RoboticsBrno/ArduinoLearningKitStarter/docs/ArduinoIDE_LibraryManager_ALKS.png

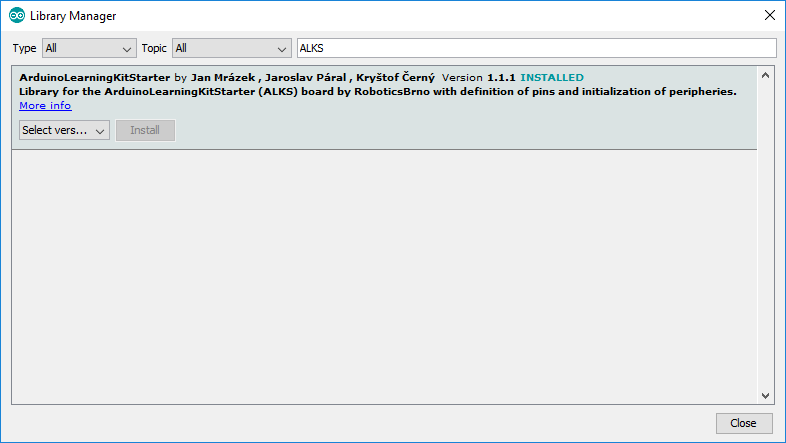
docs/ArduinoIDE_LibraryManager_ALKS.png
