RoboticsBrno/ArduinoLearningKitStarter/media/ALKS_v2.1_1.01_top.JPG

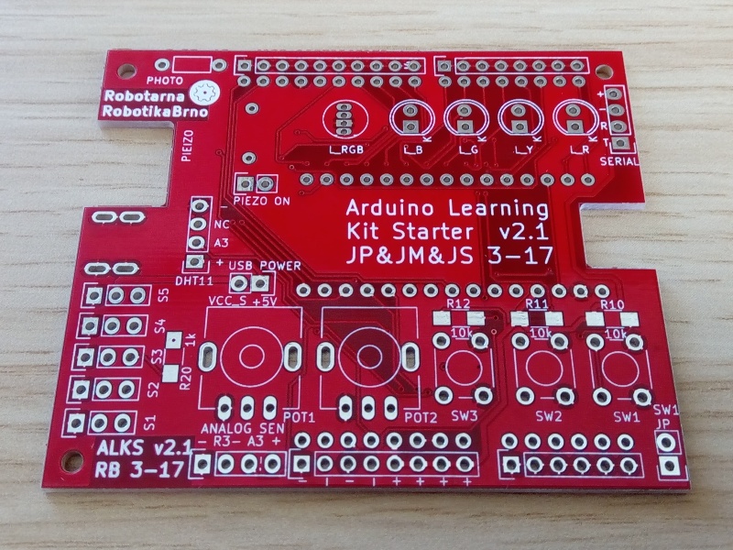
media/ALKS_v2.1_1.01_top.JPG
