RoboticsBrno/ArduinoLearningKitStarter/media/ALKS_v2.1_1.02_bot.JPG

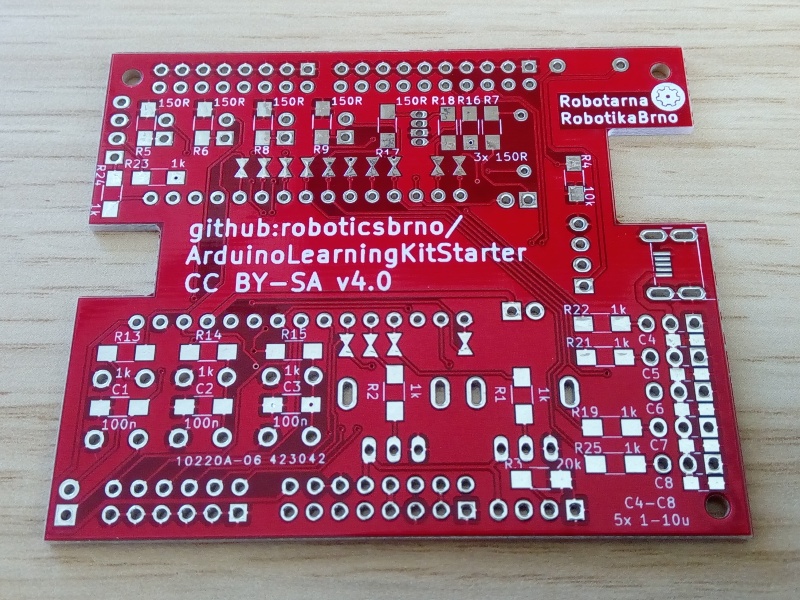
media/ALKS_v2.1_1.02_bot.JPG
