RoboticsBrno/ArduinoLearningKitStarter/(threads)

Thread 4 (2016-10-21):

Opravit pouzdro u potenciometrů + dokreslit obrys součástky do F.SilkS

JarekParal, 2016-10-21:
Nesedí velikost otvorů pro boční upevňovací nožičky (jsou moc úzké, je potřeba alespoň 2 mm).
Obrys součástky je jen v F.Fab -> potřeba přidat do F.SilkS.

JarekParal, 2017-03-31:
Rozteč mezi montážními otvory je příliš velká (potenciometry jdou špatně dát do DPS). Aktuálně je rozteč 10,8 mm a je potřeba ji zmenšit na cca. 9,8 mm (viz. http://www.taiwanalpha.com.tw/english2014/p_e_022.htm).

Closed 2017-03-31.

Thread 11 (2017-04-25):

Opravit IOREF u tlačítek, potenciometrů, světelného senzoru, DHT11, ...

JarekParal, 2017-04-25:
Je potřeba nahradit dráhy +5V za IOREF u pull-upů na tlačítka, u potenciometrů, světelného senzoru, na napájení DHT11 a je otázka co s pinheady J6 (UART/SERIAL) a J7 (analogové senzory). @cednik @yaqwsx

DHT11: [Spotřeba (str. 3)](https://www.gme.cz/data/attachments/dsh.772-137.2.pdf) čipu by měla být v desítkách miliampér a [napájecí napětí](https://www.gme.cz/data/attachments/dsh.772-137.1.pdf) od 3,3 (délka kabelu do 20 cm) do 5,5 V.

Aktuálně jsou totiž kity nekompatibilní s 3,3V procesory (ESP, ARM) a hrozí i jejich zničení.

yaqwsx, 2017-04-28:
#12 řeší.

Closed 2017-04-28.

Thread 13 (2017-05-31):

Opravit polohu a počet montážních otvorů

yaqwsx, 2017-05-31:

CornyjK, 2018-06-18:
Jak by se to mělo provést?

JarekParal, 2018-10-20:
@yaqwsx Nepamatuješ si, co přesně jsme chtěli upravit?

Přidat další díry v centimetrovém rastru?

yaqwsx, 2018-10-20:
Chceme 4 díry ve všech rozích. Chceme kulaté rohy.

Dne 20.10.2018 v 17:28 Jaroslav Páral napsal(a):
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

JarekParal, 2018-10-20:
Já myslel, že ty aktuální tři montážní otvory jsou právě Uno kompatibilní.

yaqwsx, 2018-10-20:
Vůbec, jsou na prasáka tam, kde bylo místo.

Honza

Dne 20.10.2018 v 20:38 Jaroslav Páral napsal(a):
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

JarekParal, 2018-12-20:
Finální řešení:
Součásné otvory odstranit a přidat 4 otvory, které budou odpovídat Arduino otvorům.
Přidat další 4 otvory do rohů DPS v milimetrovém/centimetrovém rastru.

Thread 16 (2017-07-09):

Chybějící popisky pinů pro ESP32

yaqwsx, 2017-07-09:
Používat pinheady s ESP32 je nepohodlné - je třeba dělat dle schématu dojí mapování

yaqwsx, 2018-01-23:
Vyřeší nová verze knihovny.

JarekParal, 2018-01-23:
A issue #20

Closed 2018-01-23.

Thread 19 (2018-01-23):

Doladit kompatibilitu Arduino - ESP32

yaqwsx, 2018-01-23:
Problémové je zejména I2C a SPI. Preferuji řešit na úrovni HW (ať je to blbuvzdornější) - tzn. defaultní piny na ESP32 (specifikované Arduino frameworkem) mapují na odpovídající piny na Arudinu.

Deska musí být použitelná jako redukce ESP32 < = > Arduino Nano < = > Arduino Uno

CornyjK, 2018-06-17:
Navrhuji uzavřít, protože je to záležitost knihovny a tam tato issue je.

JarekParal, 2018-06-18:
Řeší se v rámci issue v ALKS knihovně: https://github.com/RoboticsBrno/ArduinoLearningKitStarter-library/issues/5

Closed 2018-06-18.

Thread 20 (2018-01-23):

Přidat popisky pinů

yaqwsx, 2018-01-23:
Nejnutnější popisky přímo na desce, ostatní popisky bych přidal na vylupovací rámeček okolo celé desky (pokud budou popisky skutečně tak velké).

Nápad - v knihovně vytvořit kvůli kompatibilitě s ESP32 konstanty IO1, IO2, atd, které u Arduina budou definovány jako IO1 = 1, IO2 = 2; a u ESP32 např. IO1 = 12, IO2 = 14.

JarekParal, 2018-01-23:
Nápad (knihovna): navrhoval bych spíše přidat konstanty D1, D2, ..., A1, A2. A na DPS pak přidat klasické Arduino Uno popisky.

yaqwsx, 2018-01-23:
Souhlas

Thread 21 (2018-01-23):

Přidat konektory pro I2C a SPI

yaqwsx, 2018-01-23:
Nikdo si na Arduinu nepamatuje, kde je připojené I2C a kde je SPI. Je to třeba dohledávat a tohle je opruz. Buď chci mít popisky na desce anebo ještě extra pin heady, kde je přímo vyvedené I2C a SPI.

JarekParal, 2018-01-23:
Navrhuji nadefinovat I2C a SPI pro ESP32, tak jak je na klasickém Arduino Uno a přidat popisky na DPS pro Uno pinout.

yaqwsx, 2019-01-02:
Motivací pro mezeru byla snaha o vizuální oddělení. Můžu jí udělat větší.

Pořadí - máme nějaké zažité? Datové piny jsem dal sestupně dle čísel na
Arduinu.

st 2. 1. 2019 16:25 odesílatel Jaroslav Páral <notifications@github.com>
napsal:

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

JarekParal, 2019-01-16:
Po rychlém průzkumu konektorů na LCD displejů (většina je má tak jak jsou aktuálně na DPS) a Gyroskopů (praktický všechny to mají trochu jinak) bych konektory ponechal tak jsou a jen bych mezi nimi udělal mezeru o velikosti jednoho pindeadu (lepší pájení a jednotnost).

Thread 25 (2018-01-23):

Změna názvu knihovny pro ALKS

JarekParal, 2018-01-23:
Přejmenovat knihovnu LearningKit.h na ALKS.h (případně udělat ALKS.h jen jako include Learning.h). Děti mi v tom názvu dělají dost často chybu a nesedí to s názvem DPS.

Možná spíš issue do: https://github.com/RoboticsBrno/ArduinoLearningKitStarter-library

CornyjK, 2018-04-16:
Hotovo.

Closed 2018-04-16.

Thread 27 (2018-01-23):

Vyřešit připojení pieza na ESP32

yaqwsx, 2018-01-23:
Na ESP32 jsme v aktuální konfiguraci stále uspokojivě nerozpištěli piezo.

CornyjK, 2018-06-18:
Není to dobré řešení, ale fungovalo mi jen s jedním pinem na low a použít funkci ledc (není na AVR). Chtělo by to port knihovny ToneAC.

CornyjK, 2018-06-18:
Navrhuji zavřít, issue přesunut do RoboticsBrno/ArduinoLearningKitStarter-library#11

yaqwsx, 2018-06-18:
ToneAC dělá to, že na půl periody nastaví jednu nožičku na low a druhou na high a pak je prohodí. Díky tomu má piezo dvakrát tak velký rozkmit a je hlasitější.

To samé by mělo být možné udělat na ESPčku - nevím, jestli ledc umí invertovat pin nebo ne. Pokud ano, tak stačí nastavit oběma nožičkám PWM na 50 % a jeden pin invertovat. Pokud ne, tak by to mohly umět timery pro řízení motorů.

Thread 29 (2018-04-29):

Nefunguje SW1

CornyjK, 2018-04-29:
Alespoň na ESP32 ne, ostatní bez problémů, zkoušeni na více deskách s různými ESP32.

CornyjK, 2018-05-04:
Když mám zapojené ESP32 v ALKS a rovnou zkratuju IO15 s GND, tak to funguje,

CornyjK, 2018-05-05:
Dle mých aktuálních zjištění při zkratu R15 (rezistor sériově k tlačítku) tlačítko funguje. Možné řešení: zmenšení odporu?

Thread 30 (2018-06-11):

Opravit dokument s označením pinů

JarekParal, 2018-06-11:
Opravit dokument/tabulku s označením pinů ([XLS](https://github.com/RoboticsBrno/ArduinoLearningKitStarter/blob/master/docs/pinout.xlsx) i [PDF](https://github.com/RoboticsBrno/ArduinoLearningKitStarter/blob/master/docs/pinout.pdf)), tak aby odpovídala definici pinů v [ArduinoLearningKitStarter-library](https://github.com/RoboticsBrno/ArduinoLearningKitStarter-library) + přidat info, které označení platí pro Arduino Uno/Nano a které pro ESP32.

V budoucnu by mělo do ArduinoLearningKitStarter-library přibýt i ekvivalentní definice pinů pro ESP32 kompatibilní s Arduino Uno pinoutem ([issue 5](https://github.com/RoboticsBrno/ArduinoLearningKitStarter-library/issues/5)).

Thread 31 (2018-06-15):

Aktualizovat obrázky v readme.md

CornyjK, 2018-06-15:
Současné obrázky nejdou s dobou...

CornyjK, 2018-06-15:
Zároveň vytvořit obrázky i pro [wiki](https://github.com/RoboticsBrno/ArduinoLearningKitStarter/wiki/Nastavení-desky-ALKS).

JarekParal, 2018-06-18:
Na wiki můžeš použít tyhle obrázky/fotky: http://robotikabrno.cz/robotika-brno/navody/arduino/alks-tutorial-osazovani

Částečně by šli použít asi i na README.md.

Nové fotky nafotíme snad během tábora.

CornyjK, 2018-06-18:
Asi do wiki hodím i návod osazování.

JarekParal, 2018-06-18:
Souhlas. Přemýšlel jsem ještě, jestli celý návod nepřesunout na GitHub? @CornyjK

CornyjK, 2018-06-18:
Návod osazování?

CornyjK, 2018-06-18:
@JarekParal
Je osazovací návod ve správném znění (nejsou v něm chyby nebo změny)?

yaqwsx, 2018-06-18:
Nechceš vyrobit i obrázek s popisky pomocí https://github.com/yaqwsx/PcbDraw ?

JarekParal, 2019-06-03:
> Nechceš vyrobit i obrázek s popisky pomocí https://github.com/yaqwsx/PcbDraw ?

Ping @CornyjK ?

CornyjK, 2019-06-03:
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

Teď na to zrovna nemám čas.

Thread 32 (2018-06-18):

Vyřešit otevírání

CornyjK, 2018-06-18:
Při otevření ukáže:

```
The following libraries were not found:

robotarna_arduino-rescue

\home\xmrazek7\kicad\lib\kicad-library\library\Zilog

\home\xmrazek7\kicad\lib\kicad-library\library\xilinx

\home\xmrazek7\kicad\lib\kicad-library\library\Xicor

\home\xmrazek7\kicad\lib\kicad-library\library\Worldsemi

\home\xmrazek7\kicad\lib\kicad-library\library\video

\home\xmrazek7\kicad\lib\kicad-library\library\valves

\home\xmrazek7\kicad\lib\kicad-library\library\ttl_ieee

\home\xmrazek7\kicad\lib\kicad-library\library\transistors

\home\xmrazek7\kicad\lib\kicad-library\library\transf

\home\xmrazek7\kicad\lib\kicad-library\library\texas

\home\xmrazek7\kicad\lib\kicad-library\library\switches

\home\xmrazek7\kicad\lib\kicad-library\library\supertex

\home\xmrazek7\kicad\lib\kicad-library\library\stm32

\home\xmrazek7\kicad\lib\kicad-library\library\stm8

\home\xmrazek7\kicad\lib\kicad-library\library\siliconi

\home\xmrazek7\kicad\lib\kicad-library\library\silabs

\home\xmrazek7\kicad\lib\kicad-library\library\sensors

\home\xmrazek7\kicad\lib\kicad-library\library\rfcom

\home\xmrazek7\kicad\lib\kicad-library\library\relays

\home\xmrazek7\kicad\lib\kicad-library\library\regul

\home\xmrazek7\kicad\lib\kicad-library\library\references

\home\xmrazek7\kicad\lib\kicad-library\library\pspice

\home\xmrazek7\kicad\lib\kicad-library\library\Power_Management

\home\xmrazek7\kicad\lib\kicad-library\library\powerint

\home\xmrazek7\kicad\lib\kicad-library\library\power

\home\xmrazek7\kicad\lib\kicad-library\library\philips

\home\xmrazek7\kicad\lib\kicad-library\library\Oscillators

\home\xmrazek7\kicad\lib\kicad-library\library\opto

\home\xmrazek7\kicad\lib\kicad-library\library\onsemi

\home\xmrazek7\kicad\lib\kicad-library\library\nxp_armmcu

\home\xmrazek7\kicad\lib\kicad-library\library\nordicsemi

\home\xmrazek7\kicad\lib\kicad-library\library\msp430

\home\xmrazek7\kicad\lib\kicad-library\library\motorola

\home\xmrazek7\kicad\lib\kicad-library\library\motor_drivers

\home\xmrazek7\kicad\lib\kicad-library\library\microchip_pic32mcu

\home\xmrazek7\kicad\lib\kicad-library\library\microchip_pic18mcu

\home\xmrazek7\kicad\lib\kicad-library\library\microchip_pic16mcu

\home\xmrazek7\kicad\lib\kicad-library\library\microchip_pic12mcu

\home\xmrazek7\kicad\lib\kicad-library\library\microchip_pic10mcu

\home\xmrazek7\kicad\lib\kicad-library\library\microchip_dspic33dsc

\home\xmrazek7\kicad\lib\kicad-library\library\microchip

\home\xmrazek7\kicad\lib\kicad-library\library\microcontrollers

\home\xmrazek7\kicad\lib\kicad-library\library\memory

\home\xmrazek7\kicad\lib\kicad-library\library\maxim

\home\xmrazek7\kicad\lib\kicad-library\library\logo

\home\xmrazek7\kicad\lib\kicad-library\library\linear

\home\xmrazek7\kicad\lib\kicad-library\library\Lattice

\home\xmrazek7\kicad\lib\kicad-library\library\ir

\home\xmrazek7\kicad\lib\kicad-library\library\interface

\home\xmrazek7\kicad\lib\kicad-library\library\intel

\home\xmrazek7\kicad\lib\kicad-library\library\hc11

\home\xmrazek7\kicad\lib\kicad-library\library\graphic

\home\xmrazek7\kicad\lib\kicad-library\library\gennum

\home\xmrazek7\kicad\lib\kicad-library\library\ftdi

\home\xmrazek7\kicad\lib\kicad-library\library\ESD_Protection

\home\xmrazek7\kicad\lib\kicad-library\library\elec-unifil

\home\xmrazek7\kicad\lib\kicad-library\library\dsp

\home\xmrazek7\kicad\lib\kicad-library\library\display

\home\xmrazek7\kicad\lib\kicad-library\library\diode

\home\xmrazek7\kicad\lib\kicad-library\library\digital-audio

\home\xmrazek7\kicad\lib\kicad-library\library\device

\home\xmrazek7\kicad\lib\kicad-library\library\dc-dc

\home\xmrazek7\kicad\lib\kicad-library\library\cypress

\home\xmrazek7\kicad\lib\kicad-library\library\contrib

\home\xmrazek7\kicad\lib\kicad-library\library\conn

\home\xmrazek7\kicad\lib\kicad-library\library\cmos_ieee

\home\xmrazek7\kicad\lib\kicad-library\library\cmos4000

\home\xmrazek7\kicad\lib\kicad-library\library\brooktre

\home\xmrazek7\kicad\lib\kicad-library\library\bbd

\home\xmrazek7\kicad\lib\kicad-library\library\battery_management

\home\xmrazek7\kicad\lib\kicad-library\library\audio

\home\xmrazek7\kicad\lib\kicad-library\library\atmel

\home\xmrazek7\kicad\lib\kicad-library\library\analog_switches

\home\xmrazek7\kicad\lib\kicad-library\library\analog_devices

\home\xmrazek7\kicad\lib\kicad-library\library\Altera

\home\xmrazek7\kicad\lib\kicad-library\library\adc-dac

\home\xmrazek7\kicad\lib\kicad-library\library\actel

\home\xmrazek7\kicad\lib\kicad-library\library\ac-dc

\home\xmrazek7\kicad\lib\kicad-library\library\74xx

\home\xmrazek7\kicad\lib\kicad-library\library\74xgxx

\home\xmrazek7\kicad\lib\downloaded\shield_arduino

C:\Program Files\KiCad\share\kicad\library\graphic

C:\Program Files\KiCad\share\kicad\library\logo

\home\xmrazek7\kicad\yaqwsx_KiCAD_lib\symbols\yaqwsx
```
@yaqwsx ?

JarekParal, 2018-10-20:
@yaqwsx Lze v Kicad dělat nějak jinak reference na knihovny než do nějakých uživatelských složek? Jde přikládat knihovny přímo k projektu a referencovat je relativně vůči projektu?

JarekParal, 2018-10-30:
Jak jsi to vyřešil @CornyjK?

CornyjK, 2018-10-30:
@JarekParal v `CornyjK-WIP`.

Closed 2018-10-30.

Thread 33 (2018-10-16):

Aktualizovat seznam součástek

haberturdeur, 2018-10-16:

JarekParal, 2018-10-16:
Co přesně je za problém se seznamem součástek? Můžeš @haberturdeur dospecifikovat issue?

JarekParal, 2018-10-17:
Tady jsou seznamy všech používaných součástek na ALKS:
https://github.com/RoboticsBrno/ArduinoLearningKitStarter/wiki/Postup-osazov%C3%A1n%C3%AD
nebo
https://robotikabrno.cz/robotika-brno/navody/arduino/alks-tutorial-osazovani

Prosím případně o doplnění do [úvodní stránky](https://github.com/RoboticsBrno/ArduinoLearningKitStarter/blob/master/README.md),
