RoboticsBrno/ArduinoLearningKitStarter/docs/ArduinoLearningKitStarter.pdf

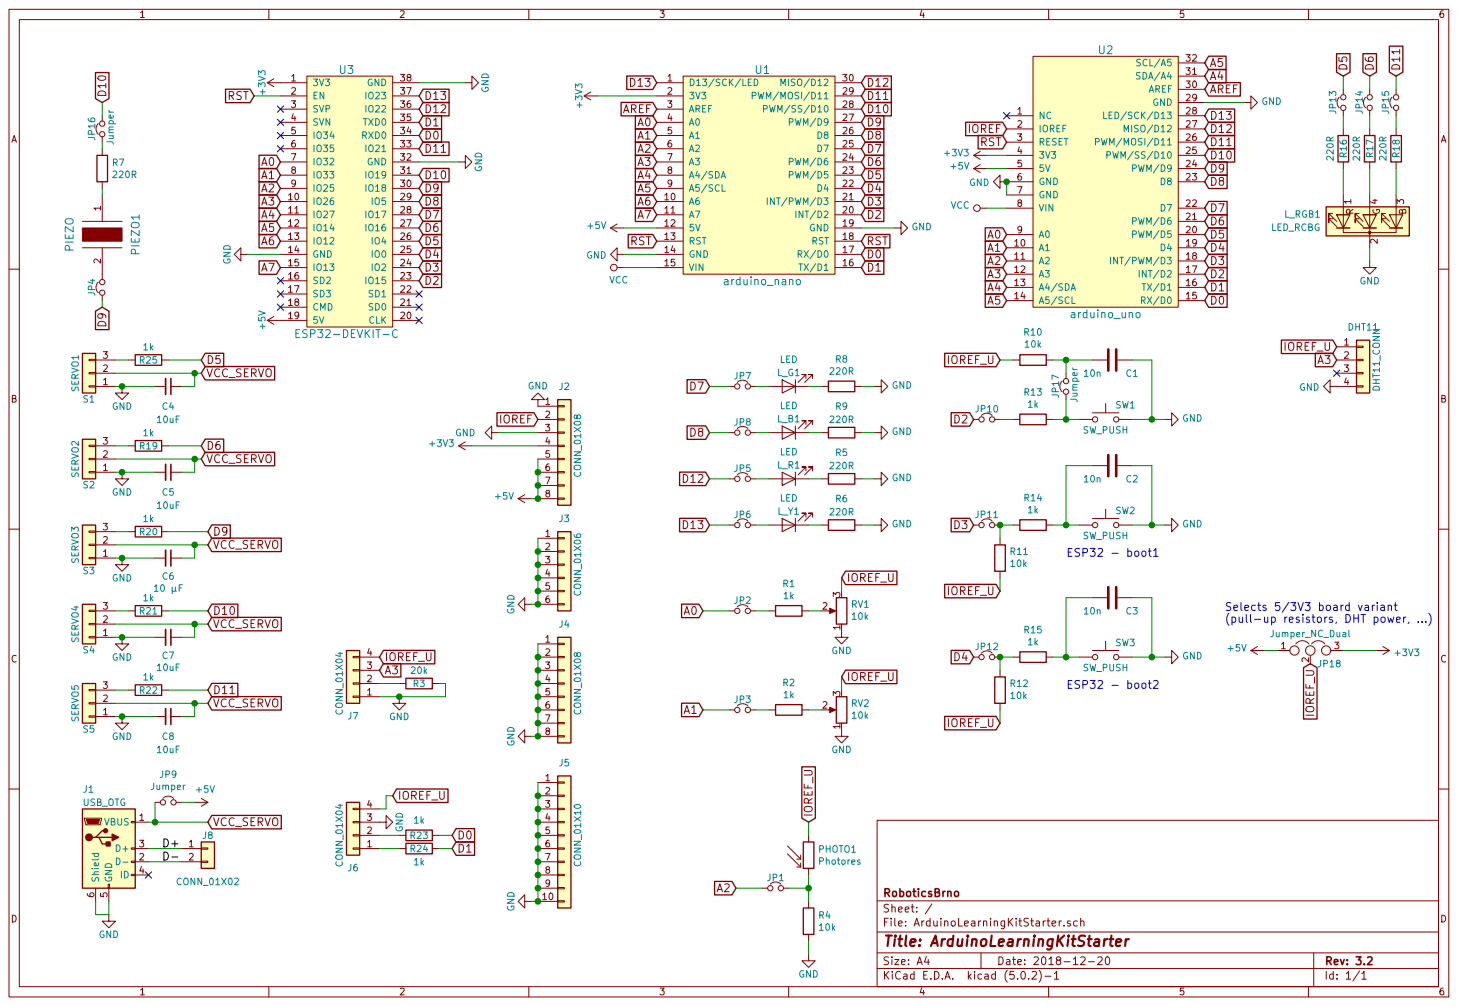
[picture p10: page 1]

(pull-up resistors, DHT power, ...) 1
VCC_SERVO

File: ArduinoLearningKitStarter.sch Sheet: / RoboticsBrno
