RoboticsBrno/ArduinoLearningKitStarter/(commit log)

2016-09-22 Initial commit.
    [robotarna_arduino.kicad_pcb, robotarna_arduino.sch]
2016-09-25 Start routing PCB, set position of parts
    [robotarna_arduino.kicad_pcb]
2016-09-30 Add some routing and remove jumpers
    [robotarna_arduino.kicad_pcb, robotarna_arduino.sch]
2016-10-03 Finish routing
    [robotarna_arduino.kicad_pcb]
2016-10-03 Add logos & labels
    [robotarna_arduino.kicad_pcb]
2016-10-04 Repair some route, add mounting hole
    [robotarna_arduino.kicad_pcb]
2016-10-04 Move outline
    [robotarna_arduino.kicad_pcb]
2016-10-05 Optimise few nets
    [robotarna_arduino.kicad_pcb]
2016-10-05 Move Robotika logo to copper
    [robotarna_arduino.kicad_pcb]
2016-10-05 Make the board a little bigger.
    [robotarna_arduino.kicad_pcb]
2016-10-08 Final version for production
    [robotarna_arduino.kicad_pcb, robotarna_arduino.sch]
2017-02-24 Make thermal reliefs thinner (close #3)
    [robotarna_arduino.kicad_pcb]
2017-02-24 Make RGB pads smaller (close #1)
    [robotarna_arduino.kicad_pcb]
2017-02-24 Fix KiCAD bug (cannot move the parts)
    [robotarna_arduino.kicad_pcb]
2017-02-24 Swap position of DHT and photo resistor (close #2)
    [robotarna_arduino.kicad_pcb]
2017-02-24 Change pot footprints and adjust position (close #4)
    [robotarna_arduino.kicad_pcb]
2017-02-24 Fix labels (#close 6)
    [robotarna_arduino.kicad_pcb, robotarna_arduino.sch]
2017-02-24 Change labels to v1.0
    [robotarna_arduino.kicad_pcb]
2017-03-09 Initial commit for version 2
    [robotarna_arduino.kicad_pcb, robotarna_arduino.sch]
2017-03-09 Final version of schematics
    [robotarna_arduino.kicad_pcb, robotarna_arduino.sch]
2017-03-12 Hide irrelevant labels, adjust few traces
    [robotarna_arduino.kicad_pcb]
2017-03-12 Add labels, mouting holes, repair some mistakes and tracks
    [robotarna_arduino.kicad_pcb, robotarna_arduino.sch]
2017-03-12 Add RB logo (Cu and SilkS layers)
    [robotarna_arduino.kicad_pcb]
2017-03-30 Make RGB LED pad smaller, publish as v2.1
    [robotarna_arduino.kicad_pcb]
2017-03-30 Repair label on L_G1 (closes #8) and check nets (closes #5)
    [robotarna_arduino.kicad_pcb]
2017-03-31 Add reference and value of components to SilkS (closes #9), add link to GitHub and license to B.SilkS
    [robotarna_arduino.kicad_pcb]
2017-03-31 Repair footprint of potentiometers and layout around (closes #4)
    [robotarna_arduino.kicad_pcb]
2017-03-31 Rename all files to ArduinoLearningKitStarter
    [ArduinoLearningKitStarter.kicad_pcb, ArduinoLearningKitStarter.sch]
2017-03-31 Change some net from 0,15 to 0,2 mm
    [ArduinoLearningKitStarter.kicad_pcb]
2017-03-31 Change labels PHOTO1 to PHOTO and PIEZO1 to PIEZO in F.SilkS
    [ArduinoLearningKitStarter.kicad_pcb]
2017-03-31 Repair problem in schema with ArduinoLearningKitStarter-rescue.lib
    [ArduinoLearningKitStarter.sch]
2017-03-31 Change labels RV1 to POT1 and RV2 to POT2 in F.SilkS
    [ArduinoLearningKitStarter.kicad_pcb]
2017-03-31 Add capacitors to servo connectors
    [ArduinoLearningKitStarter.kicad_pcb, ArduinoLearningKitStarter.sch]
2017-03-31 Add labels for conductors C4-C8 near servos connector to B.SilkS
    [ArduinoLearningKitStarter.kicad_pcb]
2017-04-02 Change labels to v2.2, repair license label (CC BY-SA v4.0 -> CC BY-SA 4.0)
    [ArduinoLearningKitStarter.kicad_pcb]
2017-04-28 Introduce jumper for user IOREF
    [ArduinoLearningKitStarter.kicad_pcb, ArduinoLearningKitStarter.sch]
2017-04-28 Initial routing of the ioref jumper
    Trace width adjustion and trace tweaking neccessary.
    [ArduinoLearningKitStarter.kicad_pcb]
2017-04-28 Finial tweaks
    [ArduinoLearningKitStarter.kicad_pcb]
2017-04-28 Reroute some tracks (+remove one collision in DRC), move IOREF_JP (JP18) and DHT11_CONN, move github label, add IOR label
    [ArduinoLearningKitStarter.kicad_pcb]
2017-04-30 Add pinhead for signals D+ and D- on USB connector
    [ArduinoLearningKitStarter.kicad_pcb, ArduinoLearningKitStarter.sch]
2017-04-30 Repair pad size of some pinheads (change from oval to circle)
    [ArduinoLearningKitStarter.kicad_pcb]
2017-05-12 Add ESP32-DevKitC to the schematics
    [ArduinoLearningKitStarter.kicad_pcb, ArduinoLearningKitStarter.sch]
2017-05-12 Unroute top part of the board
    [ArduinoLearningKitStarter.kicad_pcb]
2017-05-14 Lay out components
    [ArduinoLearningKitStarter.kicad_pcb]
2017-05-14 Initial routing
    [ArduinoLearningKitStarter.kicad_pcb]
2017-05-14 Reroute some tracks and move some labels
    [ArduinoLearningKitStarter.kicad_pcb]
2017-05-14 Final touch
    [ArduinoLearningKitStarter.kicad_pcb]
2017-05-31 Add partners' logos
    [ArduinoLearningKitStarter.kicad_pcb]
2017-05-31 Fix partners' logos and move some tracks
    [ArduinoLearningKitStarter.kicad_pcb]
2017-05-31 Change LED resistors from 150R to 220R
    [ArduinoLearningKitStarter.kicad_pcb, ArduinoLearningKitStarter.sch]
2017-07-09 Add PDF schematics
2017-07-18 Add pinout sheet
    [pinout.xlsx]
2017-10-31 Add pinout in PDF for ALKS with ESP32 DEVKIT-C
2018-10-05 Add ArduinoIDE_LibraryManager_ALKS.png - use in wiki
2018-10-05 Update README.md - ALKS-library, ESP32, photos
    Add links to ALKS-library. Add info about ESP32-DevKitC. Add header for photos and information about photos version.
2018-10-05 Update test_fw.ino - improve description of adding libraries to Arduino IDE
2018-12-20 Update schematic and board to KiCAD 5 (#37)
    * Fix schematic libraries
    * Update schematic and board to KiCAD 5
    * Remove the rescue dir
    * Update sheet info
    [ArduinoLearningKitStarter.kicad_pcb, ArduinoLearningKitStarter.sch]
2018-12-20 Change values of blocking C (#26) and fix one unroute track
    * Change values of capacitors C1, C2, C3 from 100 nF to 10 nF due to problems with flashing
    ESP32 DevKitC.
    * Fix unrouted GND track in left up corner (4th pad in second pinhead line from top of board).
    [ArduinoLearningKitStarter.kicad_pcb, ArduinoLearningKitStarter.sch]
